remrama/flicker/design/flicker-controller-2019-05-25.png

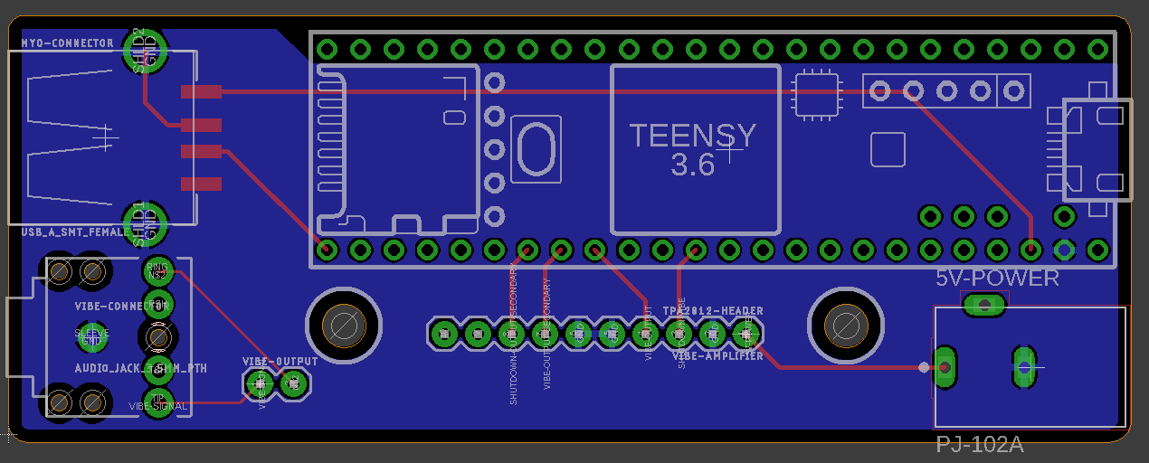
design/flicker-controller-2019-05-25.png
