remrama/flicker/design/flicker-controller_2019-03-22.png

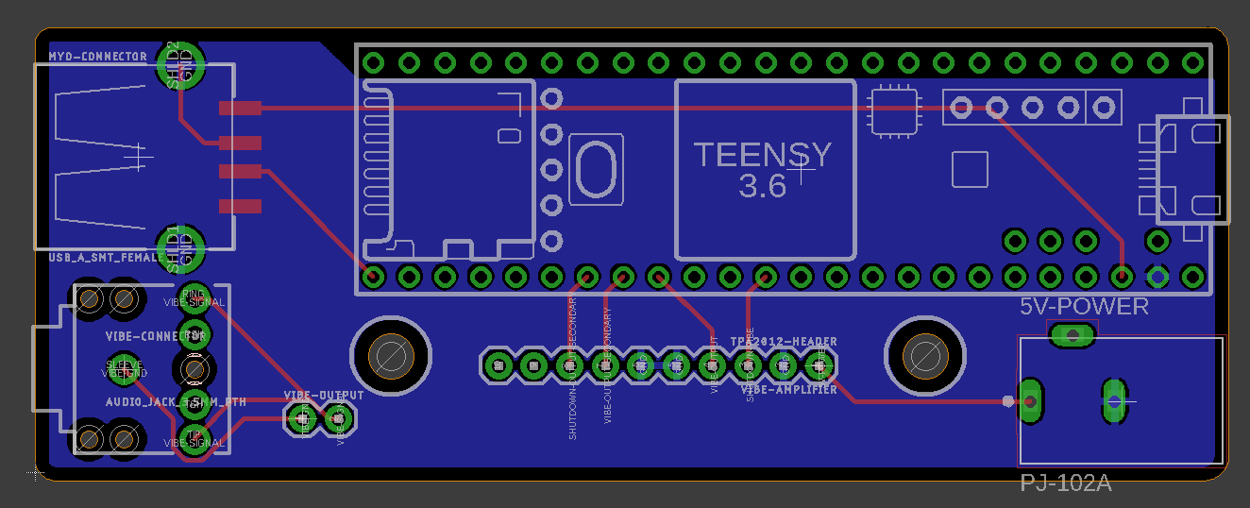
design/flicker-controller_2019-03-22.png
