remrama/flicker/(commit log)

2019-01-06 first pass at threading
2019-01-06 data examples
    [data01.csv, data02.csv, data03.csv, data04.csv, data05.csv, data06.csv, data07.csv, data08.csv]
2019-01-07 light bulb demo w/ threading script
2019-01-08 volts conversion
2019-01-10 IP, broken into sep files
    [detectorClass.py, runall.py, windowClass.py, workerClass.py]
2019-01-10 sleep data
    [data01.csv, data02.csv, data03.csv, data04.csv, data05.csv, data06.csv, data07.csv, data08.csv]
2019-01-22 new teensy location
2019-04-28 new teensy
2019-06-16 button to start generateSignal
2019-06-18 new CAD links
